keesj/TinyFPGA-BX/board/Tiny-up5k-bom.pdf

Prj: Tiny-up5k
Co.: Not Organized
Prj date: wo 07 nov 2018 08:29:51 CET
$ date: 2018-11-07 08:31:08

### Global Part Info

Refs | Value | Footprint
C17 | 10uF | Capacitor_SMD:C_0603_1608Metric
C5,C8-C11 | 100nF | Capacitor_SMD:C_0402_1005Metric
C6,C12-C14 | 10nF | Capacitor_SMD:C_0402_1005Metric
C1-C4 | 1uF | Capacitor_SMD:C_0402_1005Metric
D1 | PWR | LED_SMD:LED_0402_1005Metric
D2 | USR | LED_SMD:LED_0402_1005Metric
J1,J2 | CONN_01X14 | Pin_Headers:Pin_Header_Straight_1x14_Pitch2.54mm
J5 | Prog | Pin_Headers:Pin_Header_Straight_2x03_Pitch2.54mm_SMD
L1 | Bead | Inductors_SMD:L_0603
R1 | 1.5k | Resistor_SMD:R_0402_1005Metric
R2,R3 | 68 | Resistor_SMD:R_0402_1005Metric
R4 | 100 | Resistor_SMD:R_0402_1005Metric
R8,R9 | 680 | Resistor_SMD:R_0402_1005Metric
R5-R7,R10 | 10k | Resistor_SMD:R_0402_1005Metric
SW1 | SW_Push | Button_Switch_SMD:SW_SPST_B3U-
U1 | ICE40UP5K-SG48ITR | Package_DFN_QFN:QFN-48-1EP_7
U2 | MIC5504-3.3YM5 | Package_TO_SOT_SMD:SOT-23-5
U3 | DSC6001CI2A-016.0000T Oscillator:Oscillator_SMD_EuroQua
U4 | MIC5504-1.2YM5 | Package_TO_SOT_SMD:SOT-23-5
U5 | AT25xxx-MA | Package_DFN_QFN:DFN-8-1EP_3x
U6 | USB_OTG | Connector_USB:USB_Micro-B_GCT_

Distributors scraped by KiCost® v.1.0.3

Board Qty: | 1
| | Unit Cost: | $0.00
| | Total Cost: | $0.00

### Global Part Info

Manf# | Qty | Unit$ | Ext$
C1608X5R1A106K080AC | 1 | $0.00
C0402C104J8RACTU | 5 | $0.00
C0402C103K8RACAUTO | 4 | $0.00
CC0402KRX5R6BB105 | 4 | $0.00
KPHD-1608LVCGCK | 1 | $0.00
KPHD-1608LVCGCK | 1 | $0.00
2 | $0.00
1 | $0.00
BLM18PG300SN1D | 1 | $0.00
CRCW04021K50FKED | 1 | $0.00
CRCW040256R0FKED | 2 | $0.00
CRCW0402100RFKED | 1 | $0.00
CRCW0402680RFKED | 2 | $0.00
CRCW040210K0FKED | 4 | $0.00
B3U-1000P | 1 | $0.00
1 | $0.00
1 | $0.00
DSC6001CI2A-016.0000 | 1 | $0.00
1 | $0.00
1 | $0.00
USB3076-30-A | 1 | $0.00

ICE40UP5K-SG48ITR50 (http://www.latticesemi.com/Products/FPGAandCPLD/iCE40Ultra)
MIC5504-3.3YM5-TR

MIC5504-1.2YM5-TR (http://ww1.microchip.com/downloads/en/DeviceDoc/MIC550X.pdf)
AT25SF081-MHD-T (http://ww1.microchip.com/downloads/en/DeviceDoc/Atmel-8707-SEEPROM-AT25010B-020B-040B-Datasheet.pdf)
