keesj/TinyFPGA-BX/board/Tiny-up5k.xlsx

Prj: | Tiny-up5k |  |  |  | Board Qty: | 100
Co.: | Not Organized |  |  |  | Unit Cost: | $0.00
Prj date: | wo 07 nov 2018 08:29:51 CET |  |  |  | Total Cost: | $0.00
$ date: | 2018-11-07 08:31:08
Global Part Info
Refs | Value | Footprint | Manf# | Qty | Unit$ | Ext$
C17 | 10uF | Capacitor_SMD:C_0603_1608Metric | C1608X5R1A106K080AC | 0 |  | $0.00
C5,C8-C11 | 100nF | Capacitor_SMD:C_0402_1005Metric | C0402C104J8RACTU | 0 |  | $0.00
C6,C12-C14 | 10nF | Capacitor_SMD:C_0402_1005Metric | C0402C103K8RACAUTO | 0 |  | $0.00
C1-C4 | 1uF | Capacitor_SMD:C_0402_1005Metric | CC0402KRX5R6BB105 | 0 |  | $0.00
D1 | PWR | LED_SMD:LED_0402_1005Metric | KPHD-1608LVCGCK | 0 |  | $0.00
D2 | USR | LED_SMD:LED_0402_1005Metric | KPHD-1608LVCGCK | 0 |  | $0.00
J1,J2 | CONN_01X14 | Pin_Headers:Pin_Header_Straight_1x14_Pitch2.54mm |  | 0 |  | $0.00
J5 | Prog | Pin_Headers:Pin_Header_Straight_2x03_Pitch2.54mm_SMD |  | 0 |  | $0.00
L1 | Bead | Inductors_SMD:L_0603 | BLM18PG300SN1D | 0 |  | $0.00
R1 | 1.5k | Resistor_SMD:R_0402_1005Metric | CRCW04021K50FKED | 0 |  | $0.00
R2,R3 | 68 | Resistor_SMD:R_0402_1005Metric | CRCW040256R0FKED | 0 |  | $0.00
R4 | 100 | Resistor_SMD:R_0402_1005Metric | CRCW0402100RFKED | 0 |  | $0.00
R8,R9 | 680 | Resistor_SMD:R_0402_1005Metric | CRCW0402680RFKED | 0 |  | $0.00
R5-R7,R10 | 10k | Resistor_SMD:R_0402_1005Metric | CRCW040210K0FKED | 0 |  | $0.00
SW1 | SW_Push | Button_Switch_SMD:SW_SPST_B3U-1000P | B3U-1000P | 0 |  | $0.00
U1 | ICE40UP5K-SG48ITR | Package_DFN_QFN:QFN-48-1EP_7x7mm_P0.5mm_EP5.15x5.15mm | ICE40UP5K-SG48ITR50 (http://www.latticesemi.com/Products/FPGAandCPLD/iCE40Ultra) | 0 |  | $0.00
U2 | MIC5504-3.3YM5 | Package_TO_SOT_SMD:SOT-23-5 | MIC5504-3.3YM5-TR (http://ww1.microchip.com/downloads/en/DeviceDoc/MIC550X.pdf) | 0 |  | $0.00
U3 | DSC6001CI2A-016.0000T | Oscillator:Oscillator_SMD_EuroQuartz_XO32-4Pin_3.2x2.5mm | DSC6001CI2A-016.0000 | 0 |  | $0.00
U4 | MIC5504-1.2YM5 | Package_TO_SOT_SMD:SOT-23-5 | MIC5504-1.2YM5-TR (http://ww1.microchip.com/downloads/en/DeviceDoc/MIC550X.pdf) | 0 |  | $0.00
U5 | AT25xxx-MA | Package_DFN_QFN:DFN-8-1EP_3x2mm_P0.5mm_EP1.75x1.45mm | AT25SF081-MHD-T (http://ww1.microchip.com/downloads/en/DeviceDoc/Atmel-8707-SEEPROM-AT25010B-020B-040B-Datasheet.pdf) | 0 |  | $0.00
U6 | USB_OTG | Connector_USB:USB_Micro-B_GCT_USB3076-30-A | USB3076-30-A | 0 |  | $0.00
Distributors scraped by KiCost® v.1.0.3
