keesj/TinyFPGA-BX/board/Tiny-up5k.step

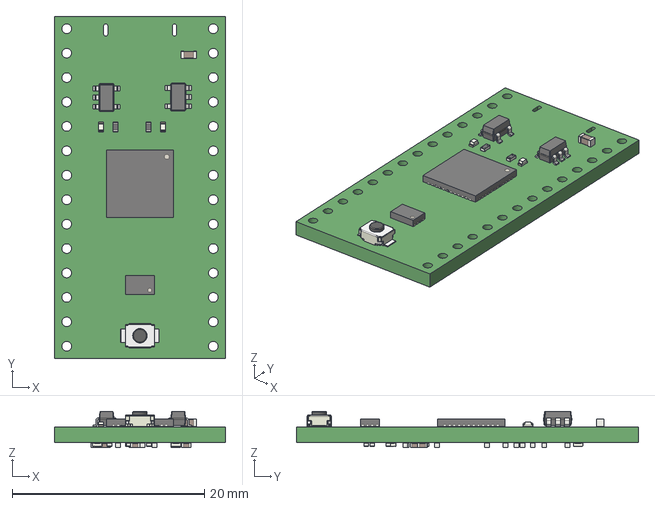
[picture p1: CAD file, 2018-11-10]
board/Tiny-up5k.step
17.8 x 35.6 x 3.79 mm
