keesj/TinyFPGA-BX/schematics.pdf

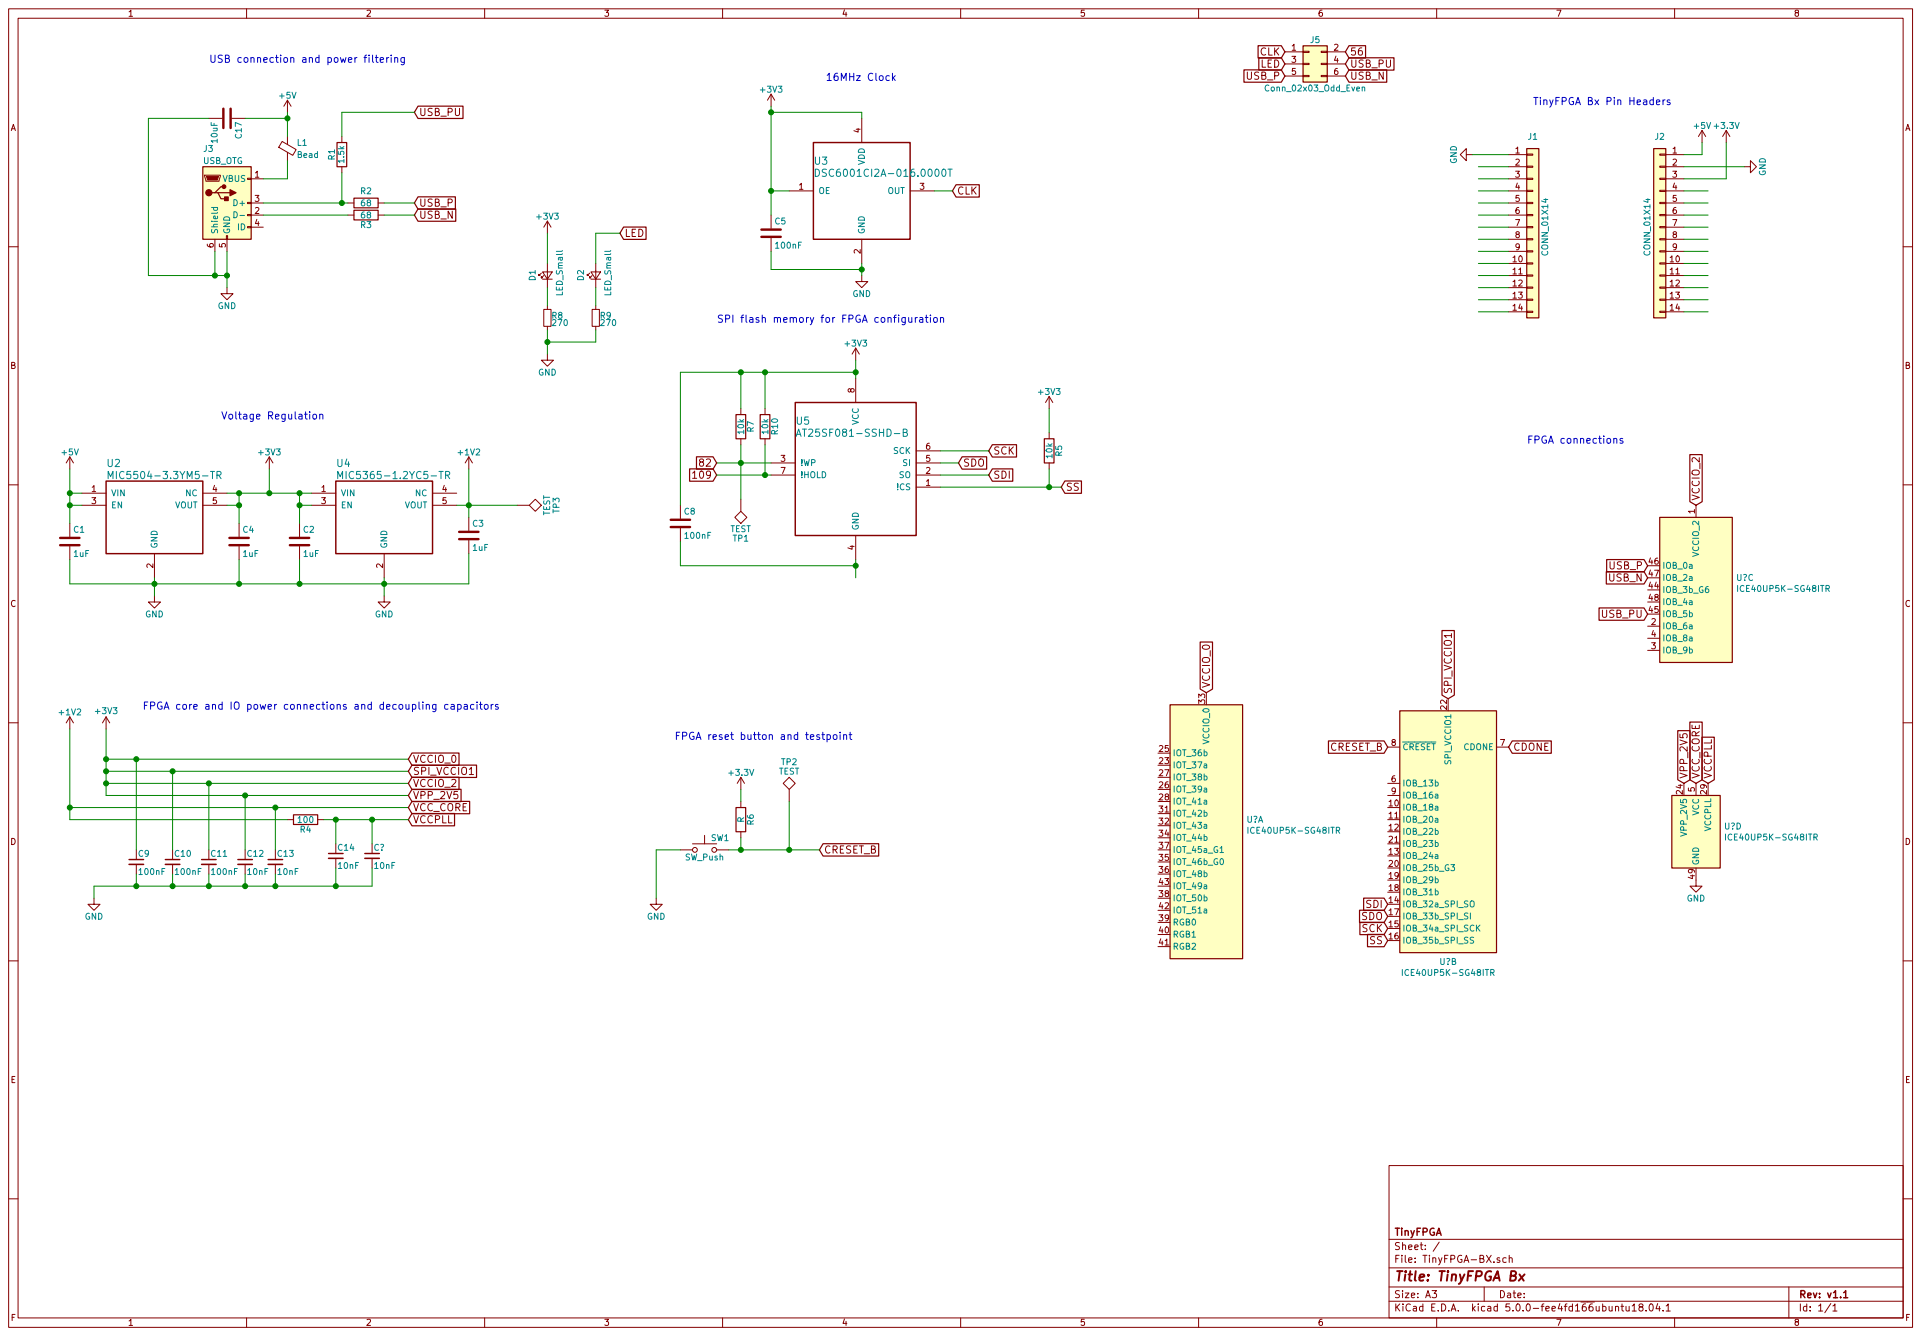
[picture p2: page 1]

USB connection and power filtering

SPI flash memory for FPGA configuration

2 EN 3 NC 4 VOUT 5 U2MIC5504-3.3YM5-TR

2 EN 3 NC 4 VOUT 5 U4MIC5365-1.2YC5-TR

TP2 TEST FPGA core and IO power connections and decoupling capacitors

FPGA reset button and testpoint

File: TinyFPGA-BX.sch Sheet: / TinyFPGA

Id: 1/1 Title: TinyFPGA Bx
