keesj/TinyFPGA-BX/board/Tiny-up5k.pdf

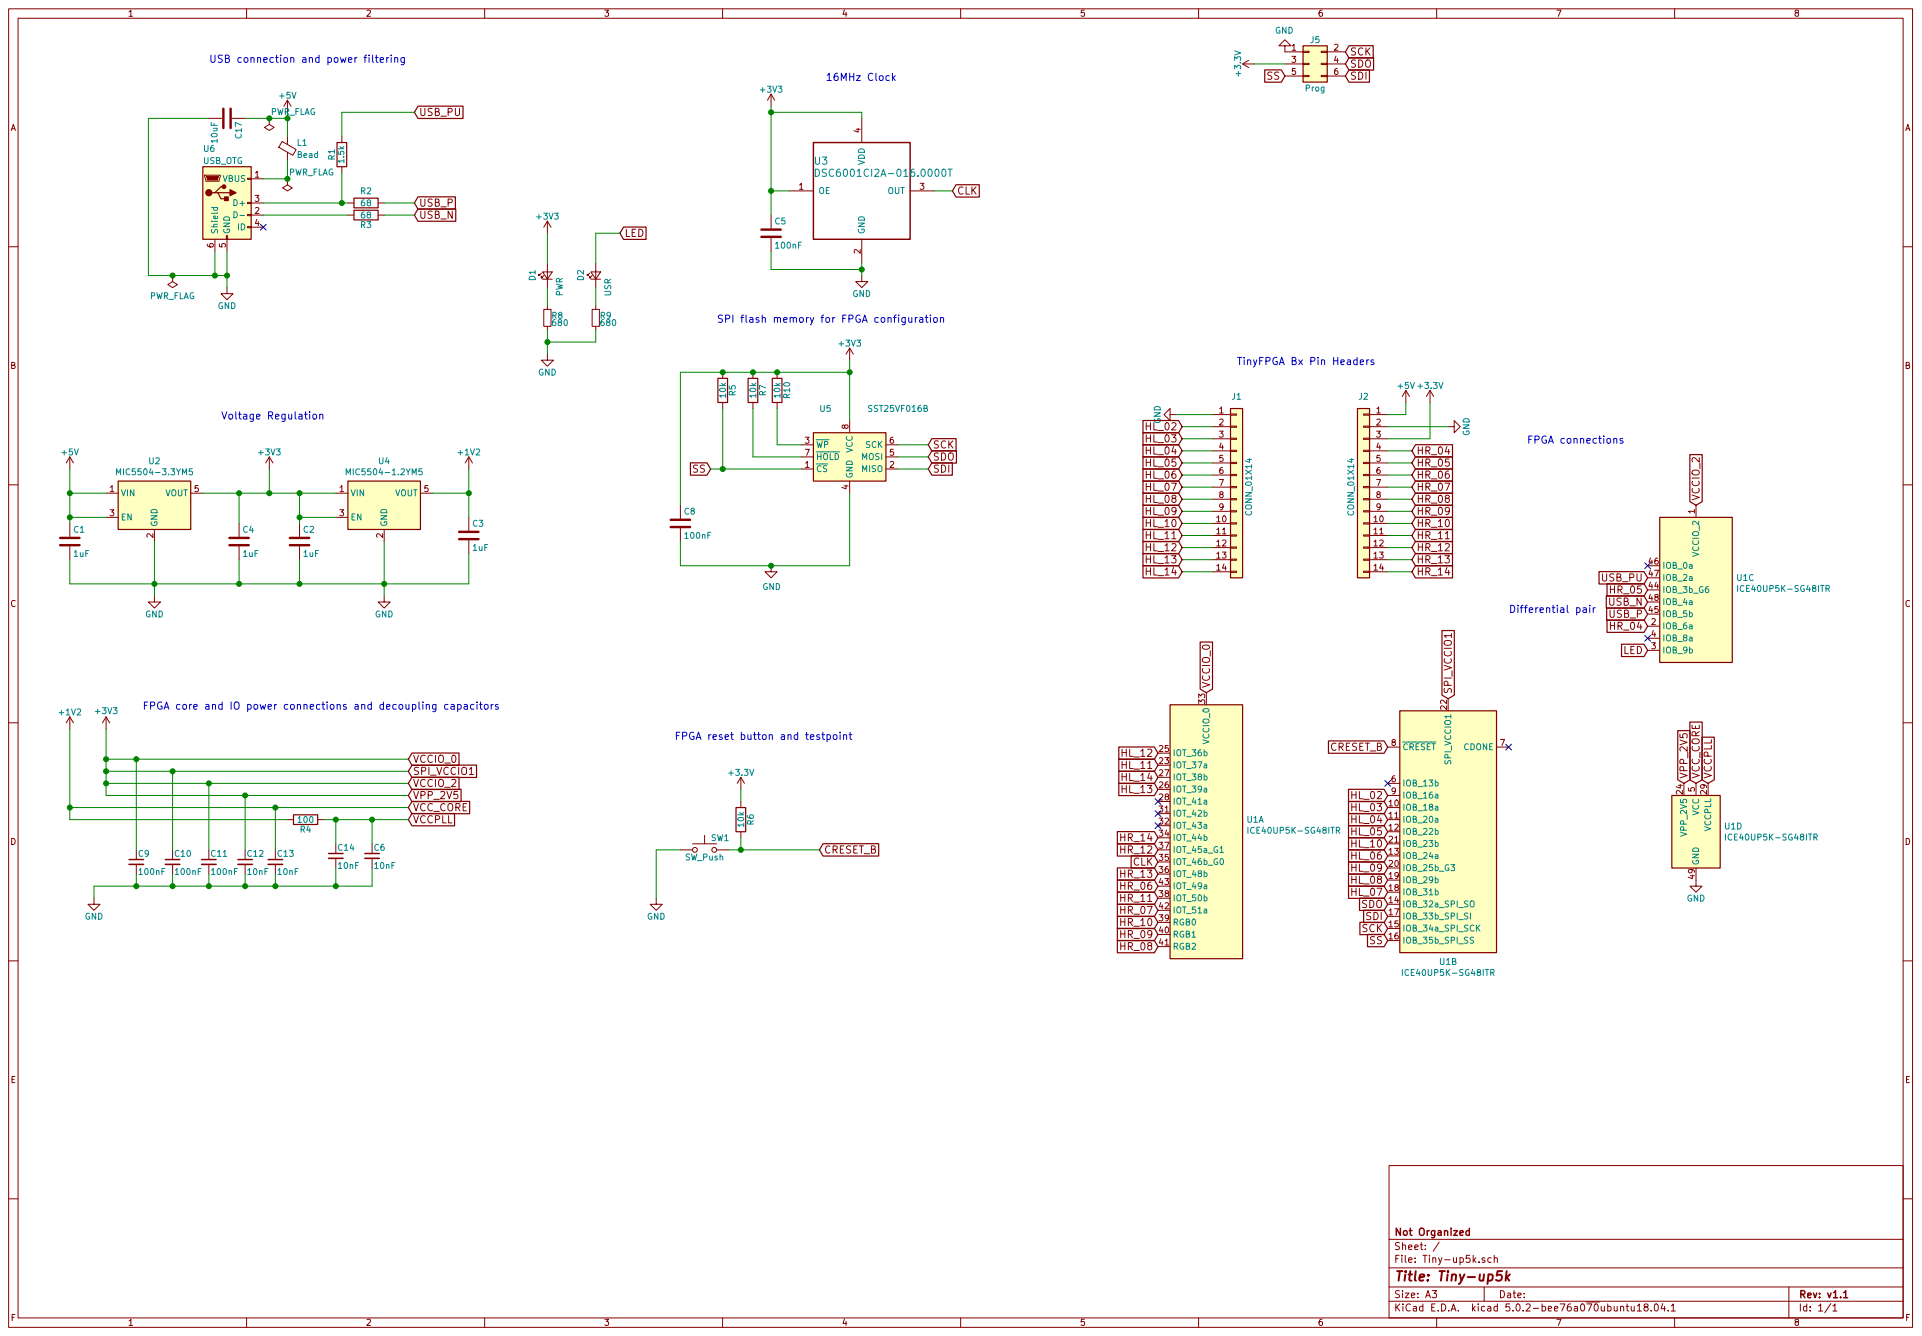
[picture p3: page 1]

USB connection and power filtering

SPI flash memory for FPGA configuration

2 EN 3 VOUT 5 U4 MIC5504-1.2YM5 CS 1 MISO 2 WP 3 GND

4 MOSI 5 SCK 6 HOLD 7 VCC

2 EN 3 VOUT 5 U2 MIC5504-3.3YM5 VIN 1 GND

FPGA core and IO power connections and decoupling capacitors

FPGA reset button and testpoint

File: Tiny-up5k.sch Sheet: / Not Organized
