keesj/TinyFPGA-BX/board/Tiny-up5k.kicad_pcb

## KiCad design board/Tiny-up5k.kicad_pcb (2018-11-21)

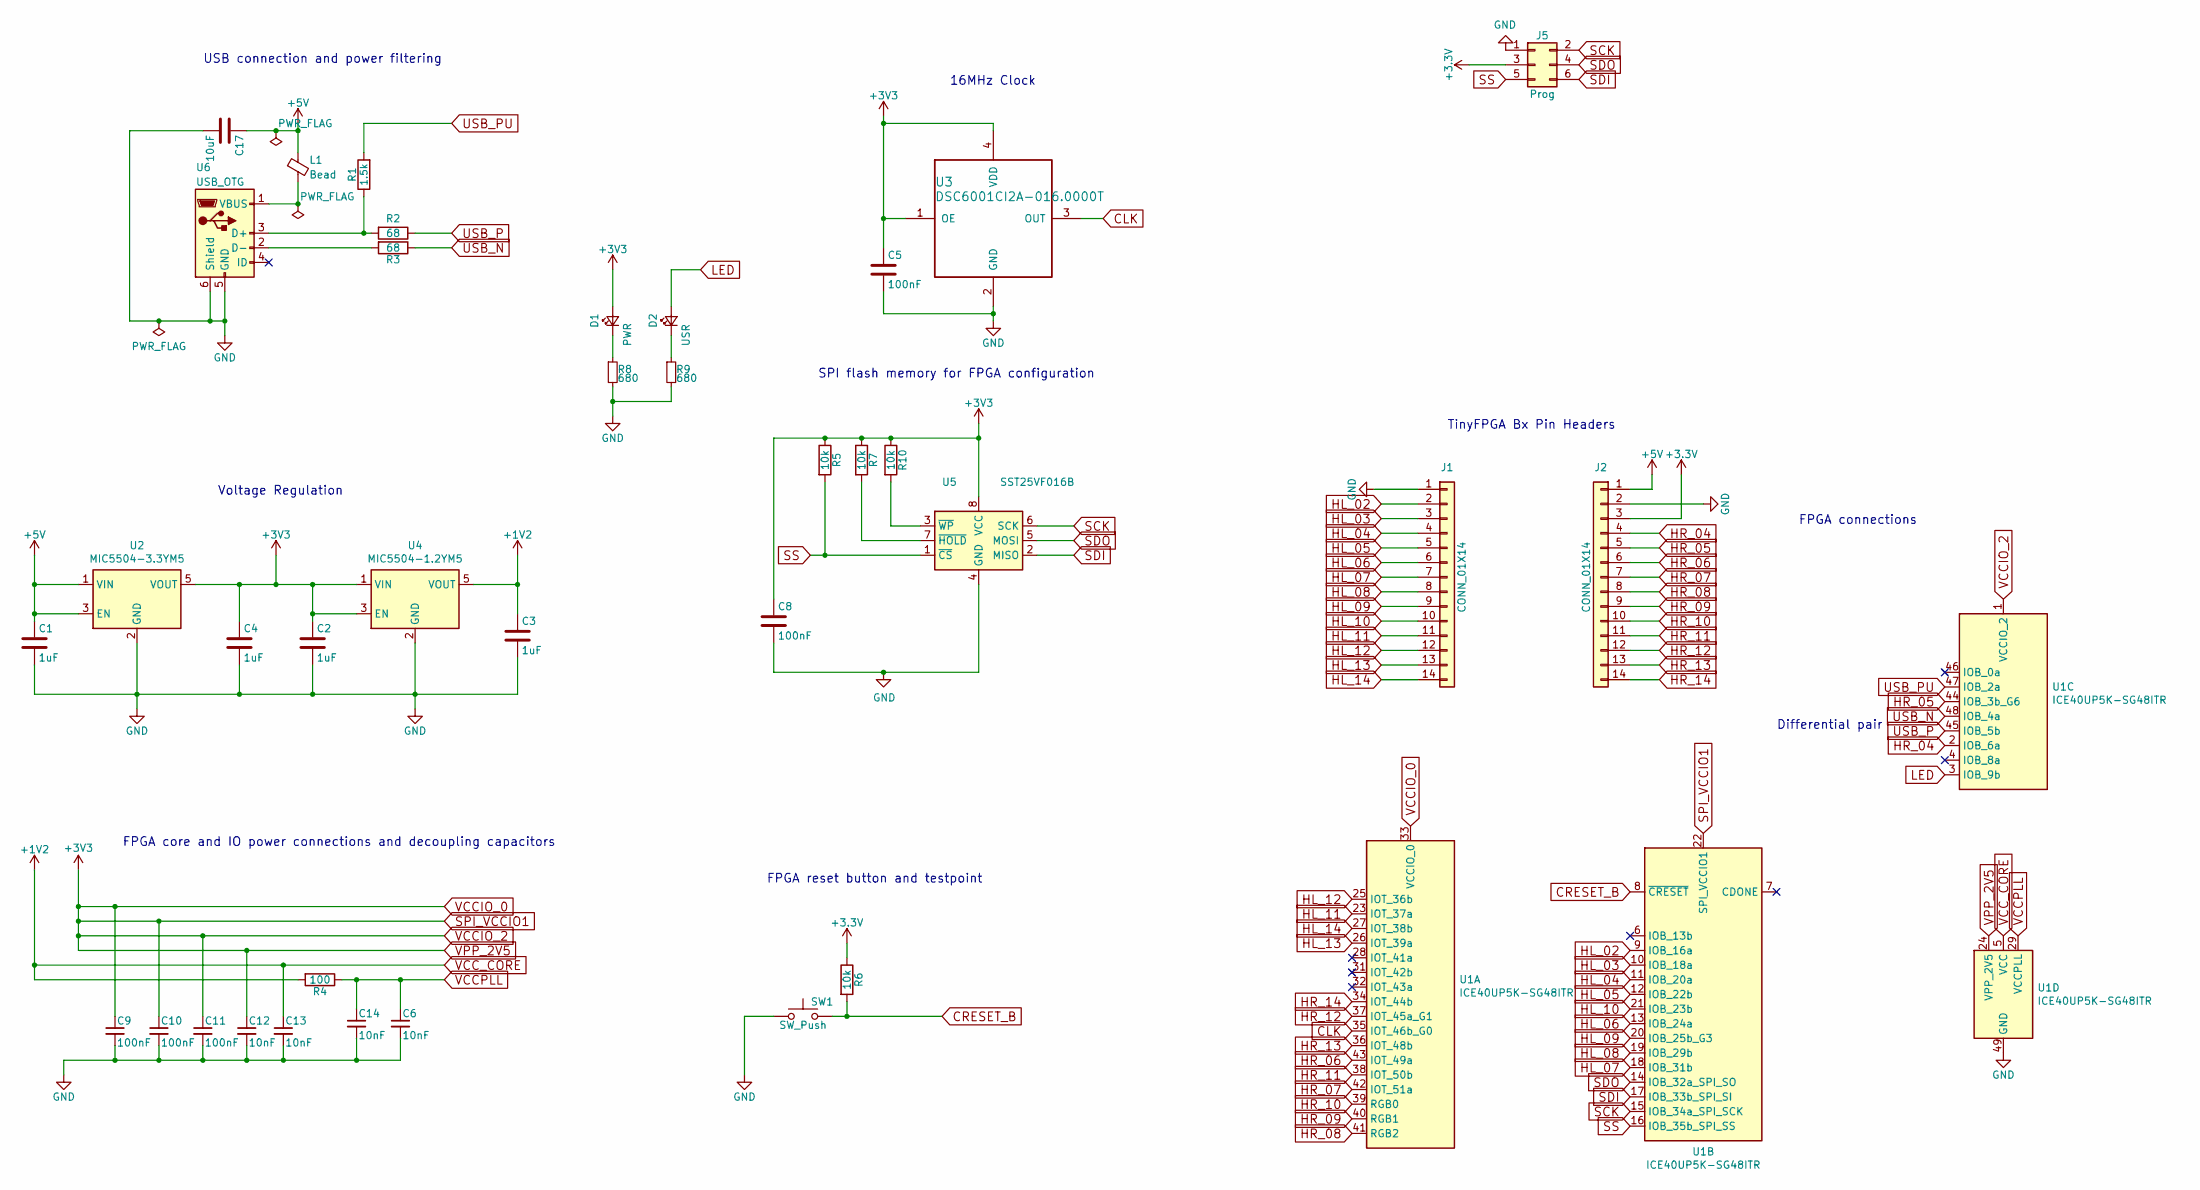
[picture p4: schematic Tiny-up5k.sch]

Parts:
C1, C2, C3, C4: 1uF; C_0402_1005Metric
C5, C8, C9, C10, C11: 100nF; C_0402_1005Metric
C6, C12, C13, C14: 10nF; C_0402_1005Metric
C17: 10uF; C_0603_1608Metric
D1: PWR; LED_0402_1005Metric
D2: USR; LED_0402_1005Metric
J1, J2: CONN_01X14; Pin_Header_Straight_1x14_Pitch2.54mm
J5: Prog; PinHeader_2x03_P2.54mm_Vertical_SMD_NoSolder
L1: Bead; L_0603
R1: 1.5k; R_0402_1005Metric
R2, R3: 68; R_0402_1005Metric
R4: 100; R_0402_1005Metric
R5, R6, R7, R10: 10k; R_0402_1005Metric
R8, R9: 680; R_0402_1005Metric
SW1: SW_Push; SW_SPST_B3U-1000P
U1: ICE40UP5K-SG48ITR; QFN-48-1EP_7x7mm_P0.5mm_EP5.15x5.15mm
U2: MIC5504-3.3YM5; SOT-23-5
U3: DSC6001CI2A-016.0000T; Oscillator_SMD_EuroQuartz_XO32-4Pin_3.2x2.5mm
U4: MIC5504-1.2YM5; SOT-23-5
U5: SST25VF016B; WSON-8-1EP_6x5mm_P1.27mm_EP3.4x4mm
U6: USB_OTG; USB_Micro-B_GCT_USB3076-30-A

Connections:
+5V: C1.1, C17.1, J2.1, L1.1, U2.1 (VIN), U2.3 (EN)
CLK: U1.35 (IOT_46b_G0), U3.3 (OUT)
CRESET_B: R6.2, SW1.2, U1.8 (~CRESET)
GND: C1.2, C2.2, C3.2, C4.2, C5.2, C6.2, C8.2, C9.2, C10.2, C11.2, C12.2, C13.2, C14.2, C17.2, J1.1, J2.2, J5.1, R8.2, R9.2, SW1.1, U1.49 (GND), U2.2 (GND), U3.2 (GND), U4.2 (GND), U5.4 (GND), U5.9 (GND), U6.5 (GND), U6.6 (Shield)
HL_02: J1.2, U1.9 (IOB_16a)
HL_03: J1.3, U1.10 (IOB_18a)
HL_04: J1.4, U1.11 (IOB_20a)
HL_05: J1.5, U1.12 (IOB_22b)
HL_06: J1.6, U1.13 (IOB_24a)
HL_07: J1.7, U1.18 (IOB_31b)
HL_08: J1.8, U1.19 (IOB_29b)
HL_09: J1.9, U1.20 (IOB_25b_G3)
HL_10: J1.10, U1.21 (IOB_23b)
HL_11: J1.11, U1.23 (IOT_37a)
HL_12: J1.12, U1.25 (IOT_36b)
HL_13: J1.13, U1.26 (IOT_39a)
HL_14: J1.14, U1.27 (IOT_38b)
HR_04: J2.4, U1.2 (IOB_6a)
HR_05: J2.5, U1.44 (IOB_3b_G6)
HR_06: J2.6, U1.43 (IOT_49a)
HR_07: J2.7, U1.42 (IOT_51a)
HR_08: J2.8, U1.41 (RGB2)
HR_09: J2.9, U1.40 (RGB1)
HR_10: J2.10, U1.39 (RGB0)
HR_11: J2.11, U1.38 (IOT_50b)
HR_12: J2.12, U1.37 (IOT_45a_G1)
HR_13: J2.13, U1.36 (IOT_48b)
HR_14: J2.14, U1.34 (IOT_44b)
LED: D2.2 (A), U1.3 (IOB_9b)
unnamed: D1.1 (K), R8.1
unnamed: D2.1 (K), R9.1
unnamed: L1.2, U6.1 (VBUS)
unnamed: R1.1, R2.2, U6.3 (D+)
unnamed: R3.2, U6.2 (D-)
unnamed: R7.2, U5.7 (~HOLD)
unnamed: R10.2, U5.3 (~WP)
SCK: J5.2, U1.15 (IOB_34a_SPI_SCK), U5.6 (SCK)
SDI: J5.6, U1.17 (IOB_33b_SPI_SI), U5.2 (MISO)
SDO: J5.4, U1.14 (IOB_32a_SPI_SO), U5.5 (MOSI)
SS: J5.5, R5.2, U1.16 (IOB_35b_SPI_SS), U5.1 (~CS)
USB_N: R3.1, U1.48 (IOB_4a)
USB_P: R2.1, U1.45 (IOB_5b)
USB_PU: R1.2, U1.47 (IOB_2a)
VCCPLL: C6.1, C14.1, R4.1, U1.29 (VCCPLL)
VCC_CORE: C3.1, C13.1, R4.2, U1.5 (VCC), U1.30 (VCC), U4.5 (VOUT)

Notes on the sheet:
FPGA core and IO power connections and decoupling capacitors
USB connection and power filtering
Voltage Regulation
16MHz Clock
SPI flash memory for FPGA configuration
FPGA reset button and testpoint
FPGA connections
TinyFPGA Bx Pin Headers
Differential pair

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
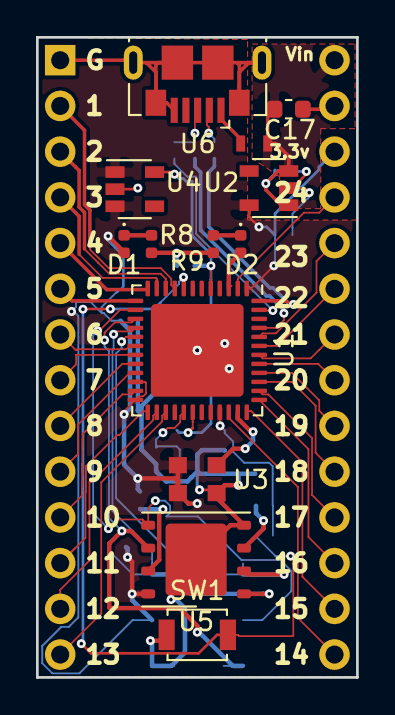
[picture p5: board Tiny-up5k.kicad_pcb from above]

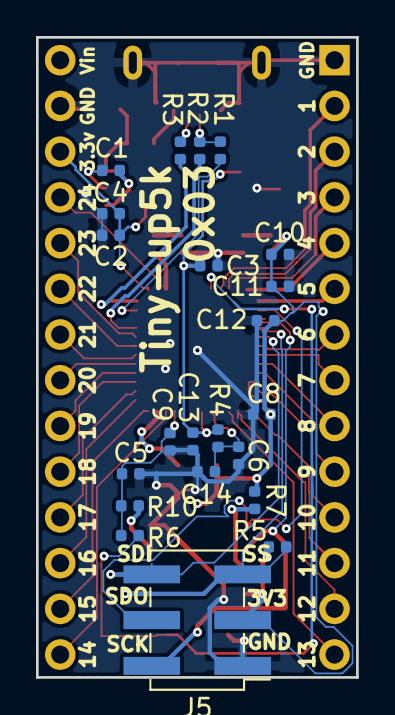
[picture p6: board Tiny-up5k.kicad_pcb from below]

Board: 2 copper layers, 17.8 x 35.6 mm, 37 parts (22 on the bottom side), 46 nets.
