keesj/TinyFPGA-BX/(commit log)

2018-10-11 After opening in kicad5
    [TinyFPGA-BX-2018-10-08-19-27-21.sch, TinyFPGA-BX.sch]
2018-10-11 Update to the boards (removed old fpga)
    [TinyFPGA-BX.kicad_pcb, TinyFPGA-BX.sch]
2018-10-12 Moving components around (replaced a few with standard model).
    Also moved resitors and capacitors to the bottom layer
    [TinyFPGA-BX.kicad_pcb, TinyFPGA-BX.sch]
2018-10-15 Cleanup (moving components for better layout)
    [TinyFPGA-BX.kicad_pcb, TinyFPGA-BX.sch]
2018-10-16 Removed a few more pins (SPI FLASH).
    This is the first PCB that passes DRC and has two layers
    [TinyFPGA-BX.kicad_pcb, TinyFPGA-BX.sch]
2018-10-16 add new schematics
2018-10-17 Checked more footprints moves some pads around.
    [TinyFPGA-BX-B.Cu.gbr, TinyFPGA-BX-B.Fab.gbr, TinyFPGA-BX-B.Mask.gbr, TinyFPGA-BX-B.Paste.gbr, TinyFPGA-BX-B.SilkS.gbr, TinyFPGA-BX-Edge.Cuts.gbr, TinyFPGA-BX-F.Cu.gbr, TinyFPGA-BX-F.Fab.gbr]
2018-10-17 Cleanup before rename
    [TinyFPGA-BX-2018-10-08-19-27-21.sch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]
2018-10-17 Rename complete
    [Tiny-up5k.kicad_pcb, Tiny-up5k.sch]
2018-10-18 Added more part numbers for the components. Changed the footprint of 5v capacitor (make it bigger) to accomodate for the bigger value.
    [Tiny-up5k.kicad_pcb, Tiny-up5k.sch, Tiny-up5k.xlsx]
2018-11-07 Fix spi flash layout size
    [Tiny-up5k.kicad_pcb, Tiny-up5k.sch, Tiny-up5k.xlsx]
2018-11-09 Increase the spacing between the leds and their resistor.
    [Tiny-up5k-B.Cu.gbr, Tiny-up5k-B.Fab.gbr, Tiny-up5k-B.Mask.gbr, Tiny-up5k-B.Paste.gbr, Tiny-up5k-B.SilkS.gbr, Tiny-up5k-Edge.Cuts.gbr, Tiny-up5k-F.Cu.gbr, Tiny-up5k-F.Fab.gbr]
2018-11-10 change j5 footprint for default kicad footprint
    [Tiny-up5k.kicad_pcb, Tiny-up5k.sch]
2018-11-10 Improve the frabrication layout. Make some trace wider
    [Tiny-up5k-B.Cu.gbr, Tiny-up5k-B.Fab.gbr, Tiny-up5k-B.Mask.gbr, Tiny-up5k-B.Paste.gbr, Tiny-up5k-B.SilkS.gbr, Tiny-up5k-Edge.Cuts.gbr, Tiny-up5k-F.Cu.gbr, Tiny-up5k-F.Fab.gbr]
2018-11-14 Replaced footprint of spi flash chip
    [Tiny-up5k.kicad_pcb, Tiny-up5k.sch]
2018-11-14 Also fix SMD pad that should get no solder
    [Tiny-up5k.kicad_pcb, Tiny-up5k.sch]
2018-11-21 Fix SPI line and send rev03 to aisler
    [Tiny-up5k.kicad_pcb, Tiny-up5k.sch]
2019-03-04 Add Interactive bom
    clone https://github.com/openscopeproject/InteractiveHtmlBom.git
    python2 ~/projects/github/InteractiveHtmlBom/InteractiveHtmlBom/generate_interactive_bom.py Tiny-up5k.kicad_pcb
2019-04-17 This code is properly working on the board
    tested using
    make -> flash.sh
    and
    apio build -> flash.sh (flash.sh needs editing to select the correct .bin file)
    [top.v]
2019-04-18 fix schematics (thanks to mnemonix)
